jseyfert3/5V-Power-Supply/5V Power Supply.kicad_pcb

## KiCad design 5V Power Supply.kicad_pcb (2025-07-19)

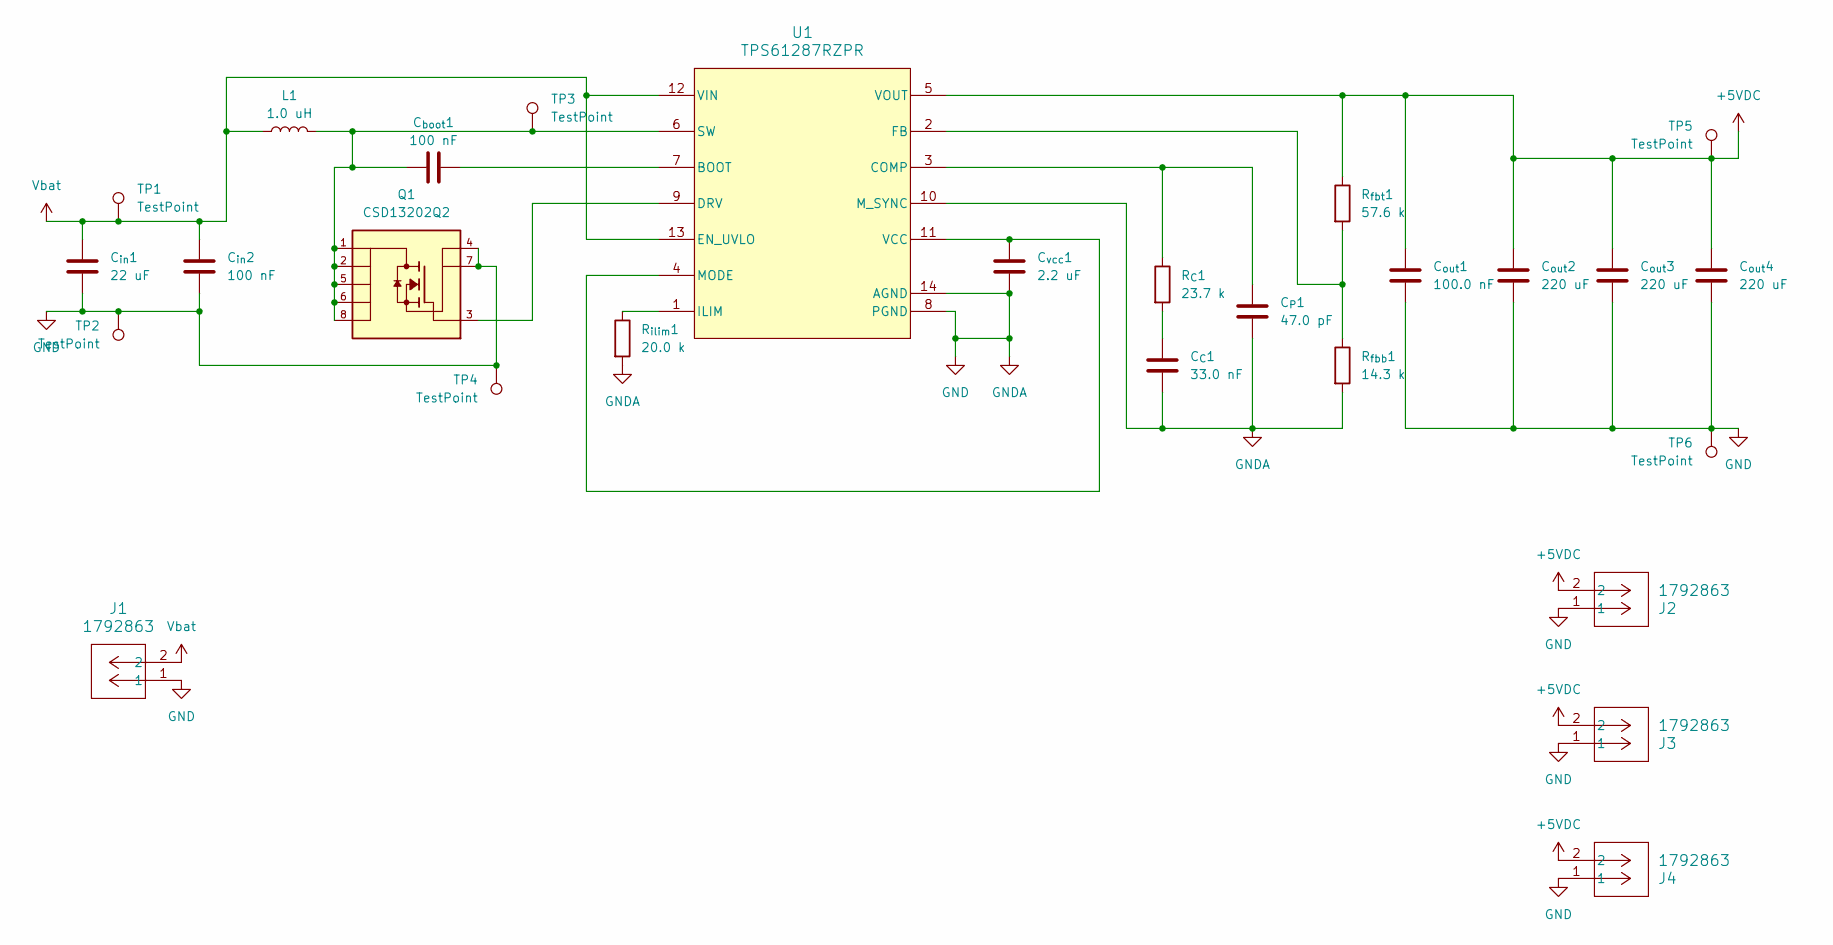
[picture p1: schematic 5V Power Supply.kicad_sch, 5V, 10 A boost supply from 3.0-4.2 VDC input schematic]

Parts:
C_{C}1: 33.0 nF; C_0402_1005Metric
C_{P}1: 47.0 pF; C_0805_2012Metric
C_{boot}1: 100 nF; C_0402_1005Metric_Pad0.74x0.62mm_HandSolder
C_{in}1: 22 uF; C_0603_1608Metric
C_{in}2: 100 nF; C_0402_1005Metric_Pad0.74x0.62mm_HandSolder
C_{out}1: 100.0 nF; C_0402_1005Metric_Pad0.74x0.62mm_HandSolder
C_{out}2, C_{out}3, C_{out}4: 220 uF; C_1206_3216Metric_Pad1.33x1.80mm_HandSolder
C_{vcc}1: 2.2 uF; C_0603_1608Metric
J1, J2, J3, J4: 1792863; CONN_1792863_PXC
L1: 1.0 uH; L_Coilcraft_XAL7070-XXX
Q1: CSD13202Q2; TRANS_CSD13202Q2; PARTREV A
R_{C}1: 23.7 k; R_0402_1005Metric
R_{fbb}1: 14.3 k; R_0402_1005Metric_Pad0.72x0.64mm_HandSolder
R_{fbt}1: 57.6 k; R_0402_1005Metric_Pad0.72x0.64mm_HandSolder
R_{ilim}1: 20.0 k; R_0402_1005Metric_Pad0.72x0.64mm_HandSolder
TP1, TP2, TP3, TP4, TP5, TP6: TestPoint; TestPoint_THTPad_D1.0mm_Drill0.5mm
U1: TPS61287RZPR; RZP0014A-MFG

Connections:
+5VDC: C_{out}1.1, C_{out}2.1, C_{out}3.1, C_{out}4.1, J2.2, J3.2, J4.2, R_{fbt}1.1, TP5.1, U1.5 (VOUT)
GND: C_{C}1.2, C_{P}1.2, C_{in}1.2, C_{in}2.2, C_{out}1.2, C_{out}2.2, C_{out}3.2, C_{out}4.2, C_{vcc}1.2, J1.1, J2.1, J3.1, J4.1, Q1.4, Q1.7, R_{fbb}1.2, R_{ilim}1.2, TP2.1, TP4.1, TP6.1, U1.8 (PGND), U1.10 (M_SYNC), U1.14 (AGND)
unnamed: C_{C}1.1, R_{C}1.2
unnamed: C_{boot}1.2, U1.7 (BOOT)
unnamed: C_{P}1.1, R_{C}1.1, U1.3 (COMP)
unnamed: Q1.3, U1.9 (DRV)
unnamed: R_{fbb}1.1, R_{fbt}1.2, U1.2 (FB)
unnamed: R_{ilim}1.1, U1.1 (ILIM)
unnamed: C_{vcc}1.1, U1.4 (MODE), U1.11 (VCC)
unnamed: C_{boot}1.1, L1.2, Q1.1, Q1.2, Q1.5, Q1.6, Q1.8, TP3.1, U1.6 (SW)
Vbat: C_{in}1.1, C_{in}2.1, J1.2, L1.1, TP1.1, U1.12 (VIN), U1.13 (EN_UVLO)

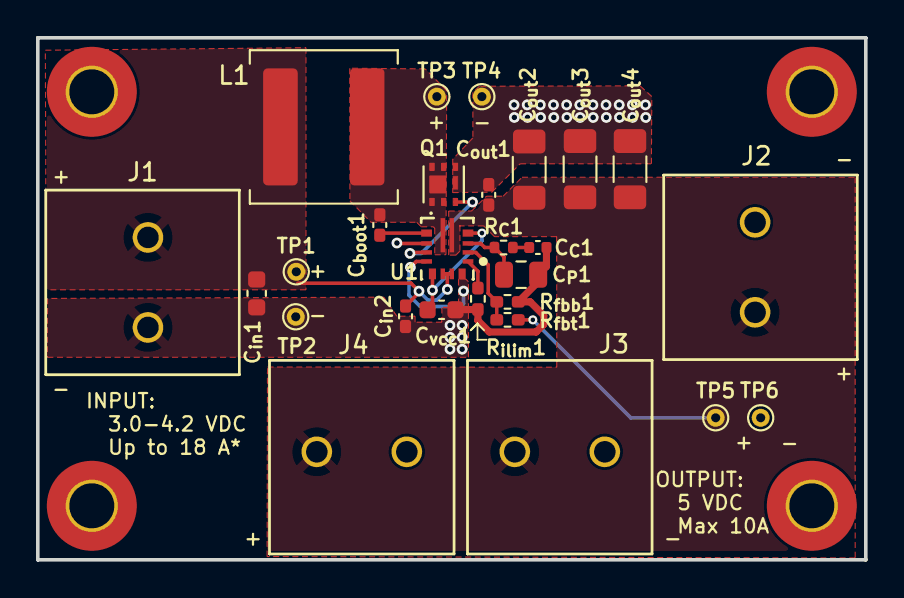
[picture p2: board 5V Power Supply.kicad_pcb from above]

Board: 2 copper layers, 46.0 x 29.0 mm, 27 parts (0 on the bottom side), 11 nets.
