jseyfert3/5V-Power-Supply/(commit log)

2025-07-10 Initial design, based on TI's WEBENCH tool.
    [5V Power Supply.kicad_pcb, 5V Power Supply.kicad_sch]
2025-07-14 feat: Mounting holes, power connectors
    Added 2.54 mm ID mounting holes and 4 power connectors. Phoenix Contact spring loaded, good to 16 A, 14-26 AWG wire. 1x on power input from batt, 3x on +5V output.
    [5V Power Supply.kicad_pcb, 5V Power Supply.kicad_sch]
2025-07-16 Added test points, silkscreening.
    Need to consider input connector. Only rated to 16 A, but at lowest input voltage and highest output current need 18 A on input.
    [5V Power Supply.kicad_pcb, 5V Power Supply.kicad_sch]
2025-07-17 Updated footprints
    * Some of the footprints didn't match the size of the part picked for this project.
    * Two of the capacitors were swapped.
    [5V Power Supply.kicad_pcb, 5V Power Supply.kicad_sch]
2025-07-19 feat: Modifications for v1.0
    * Removed vias on input GND
    * Added test points for measuring voltages. Added in pairs, with 2.5 mm spacing for O-scope spring ground probe
    * Removed +5VDC ground pour on bottom layer
    * Replaced the two 0201 components with 0402 components
    * Adjusted some of the copper pour areas
    * Adjusted/added silkscreening
    * Moved J1 to get better positioning with top GND copper pour
    [5V Power Supply.kicad_pcb, 5V Power Supply.kicad_sch]
