jseyfert3/5V-Power-Supply/(notices)

Notices in the files:
5V Power Supply.kicad_pcb:
Released under a GPL-3.0-or-layer license
Copyright 2025 Jonathan Seyfert
5V Power Supply.kicad_sch:
Released under GPL-3.0-or-later license
